hahahakeebs/Willihs/pcb/willihs.kicad_pcb

## KiCad design pcb/willihs.kicad_pcb (2025-08-03)

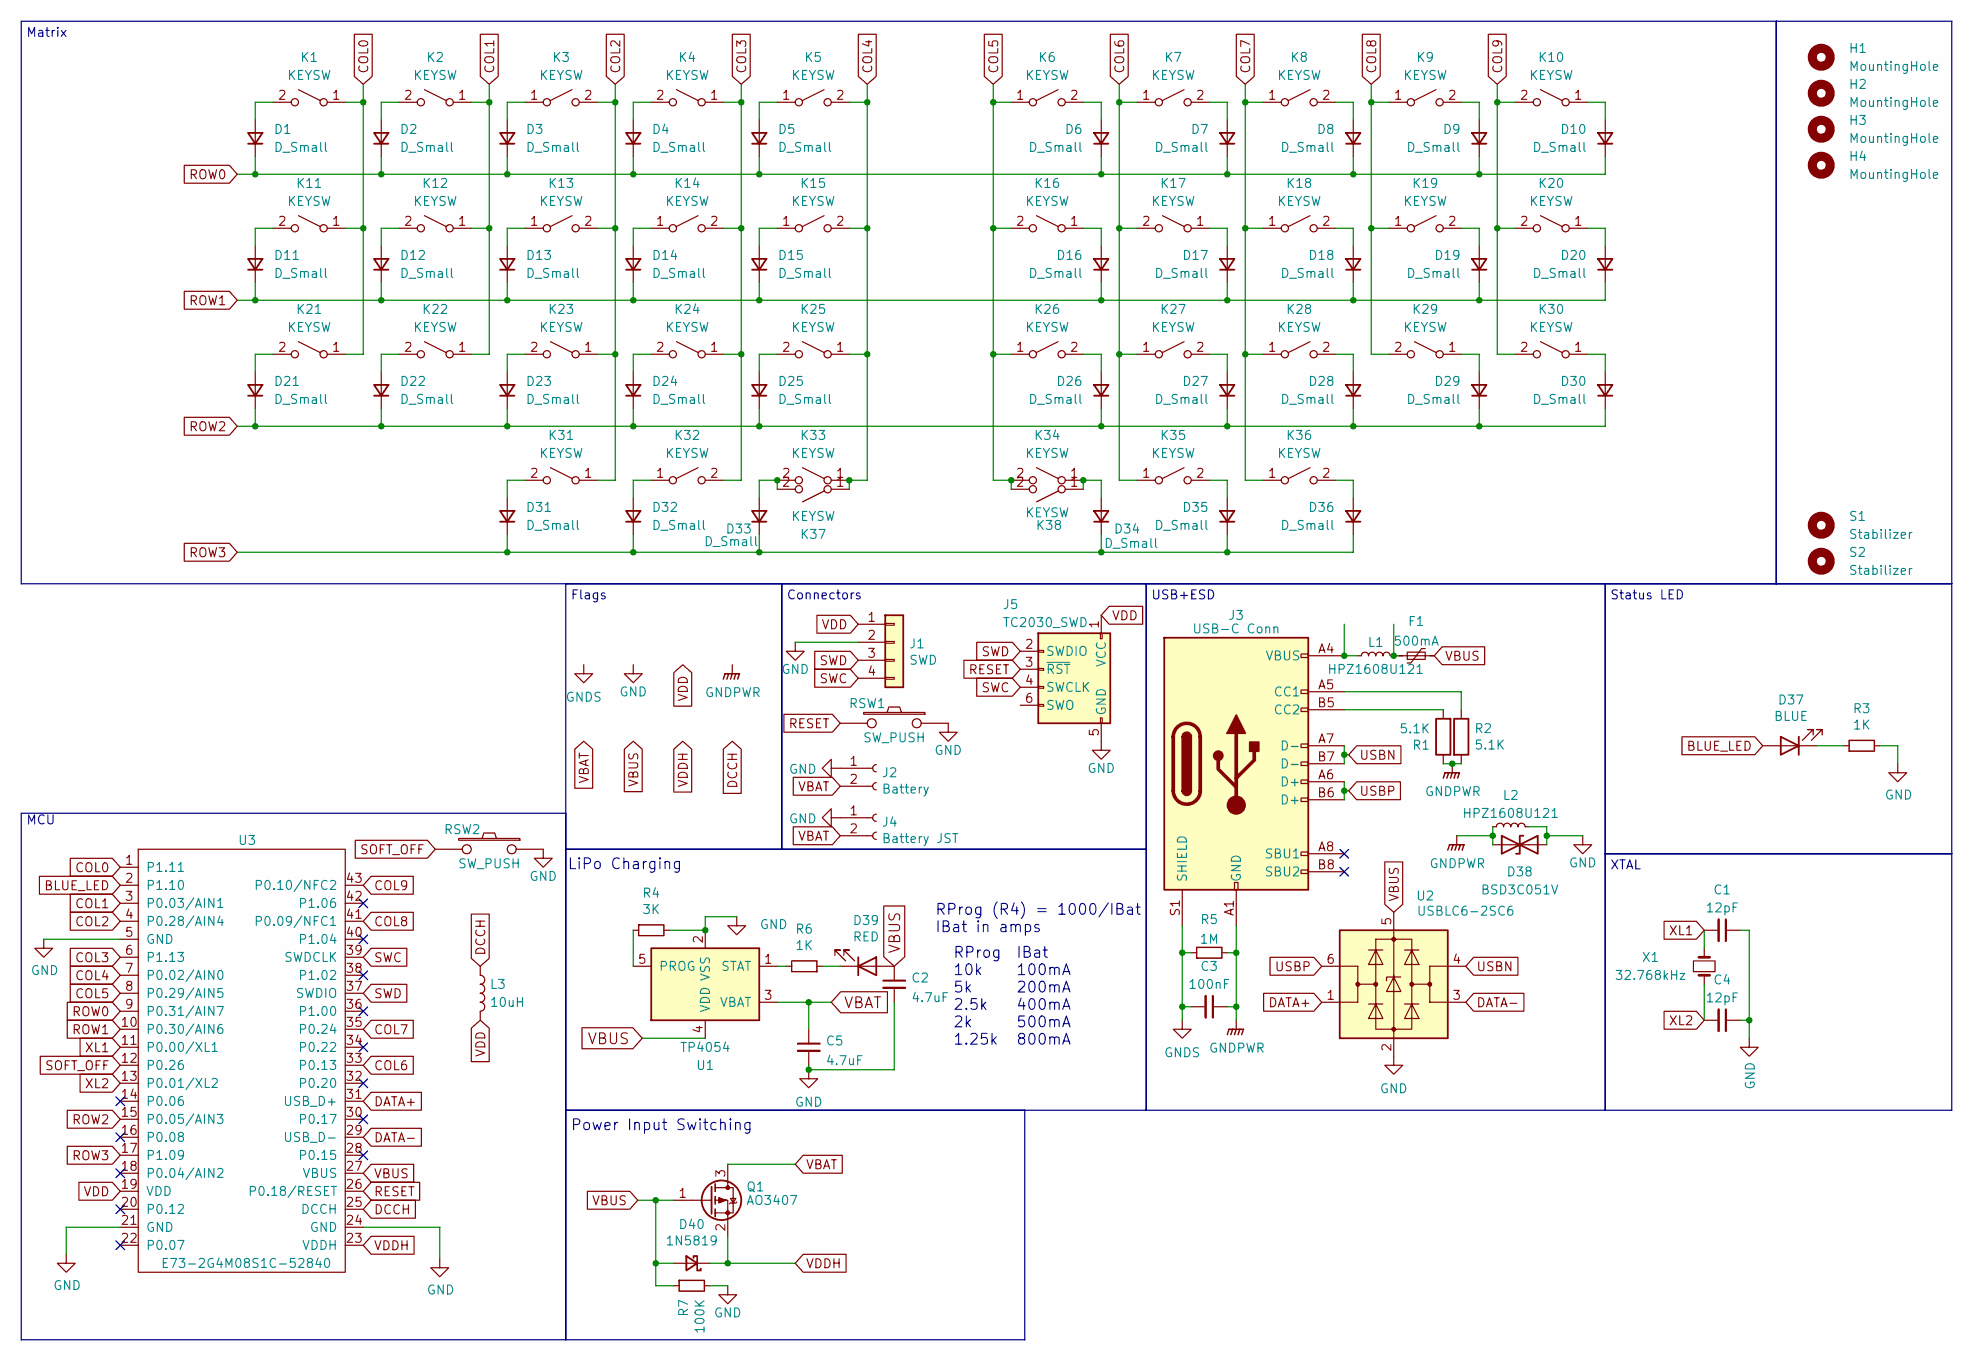
[picture p1: schematic willihs.kicad_sch, Willis]

Parts:
C1, C4: 12pF; C_0603_1608Metric_Pad1.08x0.95mm_HandSolder; LCSC C1642
C2, C5: 4.7uF; C_0603_1608Metric_Pad1.08x0.95mm_HandSolder; LCSC C19666
C3: 100nF; C_0603_1608Metric_Pad1.08x0.95mm_HandSolder; LCSC C1588
D1, D2, D3, D4, D5, D6, D7, D8, D9, D10, D11, D12, D13, D14, D15, D16, D17, D18, D19, D20, D21, D22, D23, D24, D25, D26, D27, D28, D29, D30, D31, D32, D33, D34, D35, D36: D_Small; D_SOD-323_HandSoldering; LCSC C2128
D37: BLUE; LED_1206_3216Metric_ReverseMount_Hole1.8x2.4mm; LCSC C375563
D38: BSD3C051V; D_SOD-323_HandSoldering; LCSC C151996
D39: RED; LED_1206_3216Metric_ReverseMount_Hole1.8x2.4mm; LCSC C375561
D40: 1N5819; D_SOD-323_HandSoldering; LCSC C21714236
F1: 500mA; Fuse_1206_3216Metric_Pad1.42x1.75mm_HandSolder; LCSC C883122
H1, H2, H3, H4: MountingHole; M2_Hole_TH_mod
J1: SWD; connector_swd_REV
J2: Battery; Battery_TH
J3: USB-C Conn; USB_C_Receptacle_HRO_TYPE-C-31-M-12; LCSC C165948
J4: Battery JST; JST_SH_SM02B-SRSS-TB_1x02-1MP_P1.00mm_Horizontal; LCSC C160402
J5: TC2030_SWD; CON_TC2030_outlined
K1, K2, K3, K4, K5, K6, K7, K8, K9, K10, K11, K12, K13, K14, K15, K16, K17, K18, K19, K20, K21, K22, K23, K24, K25, K26, K27, K28, K29, K30, K31, K32, K33, K34, K35, K36, K37, K38: KEYSW; SW_MX_1u
L1, L2: HPZ1608U121; L_0603_1608Metric_Pad1.05x0.95mm_HandSolder; LCSC C919153
L3: 10uH; L_0603_1608Metric_Pad1.05x0.95mm_HandSolder; LCSC C275361
Q1: AO3407; SOT-23_Handsoldering; LCSC C5148473
R1, R2: 5.1K; R_0603_1608Metric_Pad0.98x0.95mm_HandSolder; LCSC C105580
R3, R6: 1K; R_0603_1608Metric_Pad0.98x0.95mm_HandSolder; LCSC C22548
R4: 3K; R_0603_1608Metric_Pad0.98x0.95mm_HandSolder; LCSC C4211
R5: 1M; R_0603_1608Metric_Pad0.98x0.95mm_HandSolder; LCSC C22935
R7: 100K; R_0603_1608Metric_Pad0.98x0.95mm_HandSolder; LCSC C14675
RSW1, RSW2: SW_PUSH; SW_SPST_EVQP7C; LCSC C388883
S1, S2: Stabilizer; STAB_MX_P_2u
U1: TP4054; SOT-23-5_HandSoldering; LCSC C424093
U2: USBLC6-2SC6; TSOT-23-6_HandSoldering; LCSC C558442
U3: E73-2G4M08S1C-52840; LCSC C356849
X1: 32.768kHz; Crystal_SMD_MicroCrystal_CM9V-T1A-2Pin_1.6x1.0mm_HandSolder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; LCSC C383846

Connections:
BLUE_LED: D37.2 (A), U3.2 (P1.10)
COL0: K1.1 (A), K11.1 (A), K21.1 (A), U3.1 (P1.11)
COL1: K2.1 (A), K12.1 (A), K22.1 (A), U3.3 (P0.03/AIN1)
COL2: K3.2 (B), K13.2 (B), K23.1 (A), K31.1 (A), U3.4 (P0.28/AIN4)
COL3: K4.1 (A), K14.2 (B), K24.1 (A), K32.2 (B), U3.6 (P1.13)
COL4: K5.2 (B), K15.2 (B), K25.1 (A), K33.1 (A), K37.1 (A), U3.7 (P0.02/AIN0)
COL5: K6.1 (A), K16.2 (B), K26.1 (A), K34.2 (B), K38.2 (B), U3.8 (P0.29/AIN5)
COL6: K7.1 (A), K17.2 (B), K27.1 (A), K35.1 (A), U3.33 (P0.13)
COL7: K8.1 (A), K18.1 (A), K28.1 (A), K36.1 (A), U3.35 (P0.24)
COL8: K9.1 (A), K19.1 (A), K29.2 (B), U3.41 (P0.09/NFC1)
COL9: K10.2 (B), K20.2 (B), K30.2 (B), U3.43 (P0.10/NFC2)
DATA+: U2.1 (I/O1), U3.31 (USB_D+)
DATA-: U2.3 (I/O2), U3.29 (USB_D-)
DCCH: L3.1, U3.25 (DCCH)
GND: C1.1, C2.2, C4.1, C5.2, D38.2 (A2), J1.2, J2.1, J4.1, J5.5 (GND), L2.2, R3.2, R4.2, R7.2, RSW1.1, RSW2.1, U1.2 (VSS), U2.2 (GND), U3.5 (GND), U3.21 (GND), U3.24 (GND)
GNDPWR: C3.1, D38.1 (A1), J3.A1 (GND), J3.A12 (GND), J3.B1 (GND), J3.B12 (GND), L2.1, R1.1, R2.2, R5.2
GNDS: C3.2, J3.S1 (SHIELD), R5.1
unnamed: D1.2 (A), K1.2 (B)
unnamed: D2.2 (A), K2.2 (B)
unnamed: D3.2 (A), K3.1 (A)
unnamed: D4.2 (A), K4.2 (B)
unnamed: D5.2 (A), K5.1 (A)
unnamed: D6.2 (A), K6.2 (B)
unnamed: D7.2 (A), K7.2 (B)
unnamed: D8.2 (A), K8.2 (B)
unnamed: D9.2 (A), K9.2 (B)
unnamed: D10.2 (A), K10.1 (A)
unnamed: D11.2 (A), K11.2 (B)
unnamed: D12.2 (A), K12.2 (B)
unnamed: D13.2 (A), K13.1 (A)
unnamed: D14.2 (A), K14.1 (A)
unnamed: D15.2 (A), K15.1 (A)
unnamed: D16.2 (A), K16.1 (A)
unnamed: D17.2 (A), K17.1 (A)
unnamed: D18.2 (A), K18.2 (B)
unnamed: D19.2 (A), K19.2 (B)
unnamed: D20.2 (A), K20.1 (A)
unnamed: D21.2 (A), K21.2 (B)
unnamed: D22.2 (A), K22.2 (B)
unnamed: D23.2 (A), K23.2 (B)
unnamed: D24.2 (A), K24.2 (B)
unnamed: D25.2 (A), K25.2 (B)
unnamed: D26.2 (A), K26.2 (B)
unnamed: D27.2 (A), K27.2 (B)
unnamed: D28.2 (A), K28.2 (B)
unnamed: D29.2 (A), K29.1 (A)
unnamed: D30.2 (A), K30.1 (A)
unnamed: D31.2 (A), K31.2 (B)
unnamed: D32.2 (A), K32.1 (A)
unnamed: D33.2 (A), K33.2 (B), K37.2 (B)
unnamed: D34.2 (A), K34.1 (A), K38.1 (A)
unnamed: D35.2 (A), K35.2 (B)
unnamed: D36.2 (A), K36.2 (B)
unnamed: D37.1 (K), R3.1
unnamed: D39.1 (K), R6.1
unnamed: F1.1, L1.2
unnamed: J3.A5 (CC1), R2.1
unnamed: J3.B5 (CC2), R1.2
unnamed: J3.A4 (VBUS), J3.A9 (VBUS), J3.B4 (VBUS), J3.B9 (VBUS), L1.1
unnamed: R4.1, U1.5 (PROG)
unnamed: R6.2, U1.1 (STAT)
RESET: J5.3 (~RST), RSW1.2, U3.26 (P0.18/RESET)
ROW0: D1.1 (K), D2.1 (K), D3.1 (K), D4.1 (K), D5.1 (K), D6.1 (K), D7.1 (K), D8.1 (K), D9.1 (K), D10.1 (K), U3.9 (P0.31/AIN7)
ROW1: D11.1 (K), D12.1 (K), D13.1 (K), D14.1 (K), D15.1 (K), D16.1 (K), D17.1 (K), D18.1 (K), D19.1 (K), D20.1 (K), U3.10 (P0.30/AIN6)
ROW2: D21.1 (K), D22.1 (K), D23.1 (K), D24.1 (K), D25.1 (K), D26.1 (K), D27.1 (K), D28.1 (K), D29.1 (K), D30.1 (K), U3.15 (P0.05/AIN3)
ROW3: D31.1 (K), D32.1 (K), D33.1 (K), D34.1 (K), D35.1 (K), D36.1 (K), U3.17 (P1.09)
SOFT_OFF: RSW2.2, U3.12 (P0.26)
SWC: J1.4, J5.4 (SWCLK), U3.39 (SWDCLK)
SWD: J1.3, J5.2 (SWDIO), U3.37 (SWDIO)
USBN: J3.A7 (D-), J3.B7 (D-), U2.4 (I/O2)
USBP: J3.A6 (D+), J3.B6 (D+), U2.6 (I/O1)
VBAT: C5.1, J2.2, J4.2, Q1.3 (D), U1.3 (VBAT)
VBUS: C2.1, D39.2 (A), D40.2 (A), F1.2, Q1.1 (G), R7.1, U1.4 (VDD), U2.5 (VBUS), U3.27 (VBUS)
VDD: J1.1, J5.1 (VCC), L3.2, U3.19 (VDD)
VDDH: D40.1 (K), Q1.2 (S), U3.23 (VDDH)
XL1: C1.2, U3.11 (P0.00/XL1), X1.2
XL2: C4.2, U3.13 (P0.01/XL2), X1.1

Notes on the sheet:
Power Input Switching
Status LED
Connectors
XTAL
USB+ESD
RProg (R4) = 1000/IBat IBat in amps
MCU
RProg 10k 5k 2.5k 2k 1.25k
Flags
LiPo Charging
Matrix
IBat 100mA 200mA 400mA 500mA 800mA

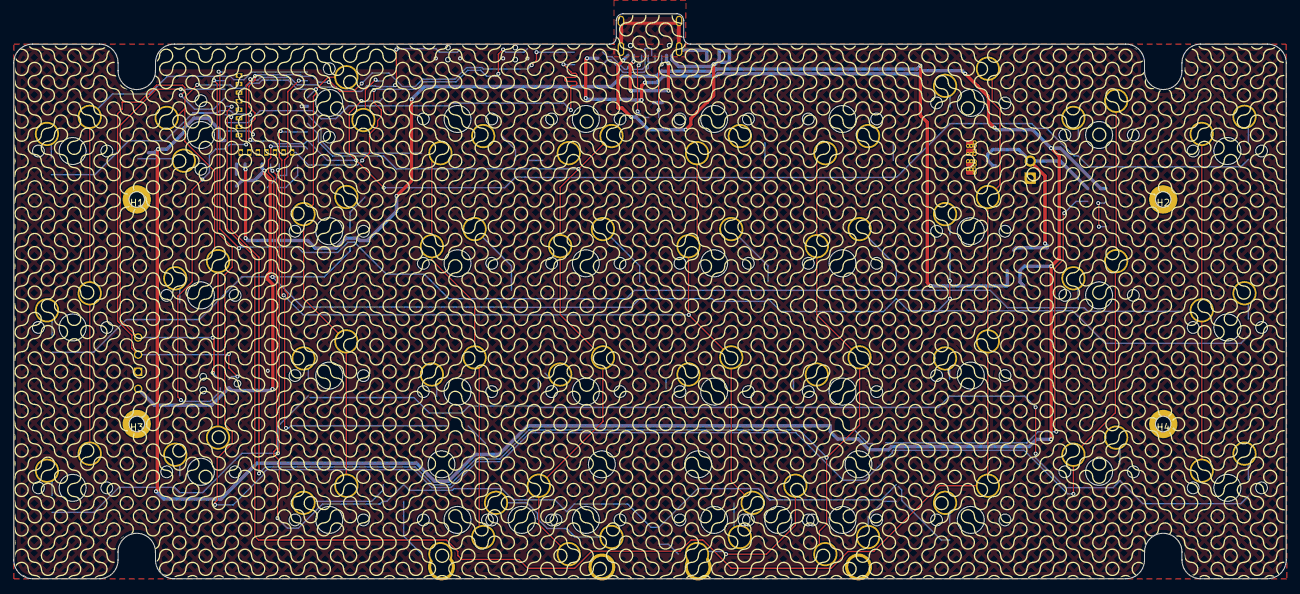
[picture p2: board willihs.kicad_pcb from above]

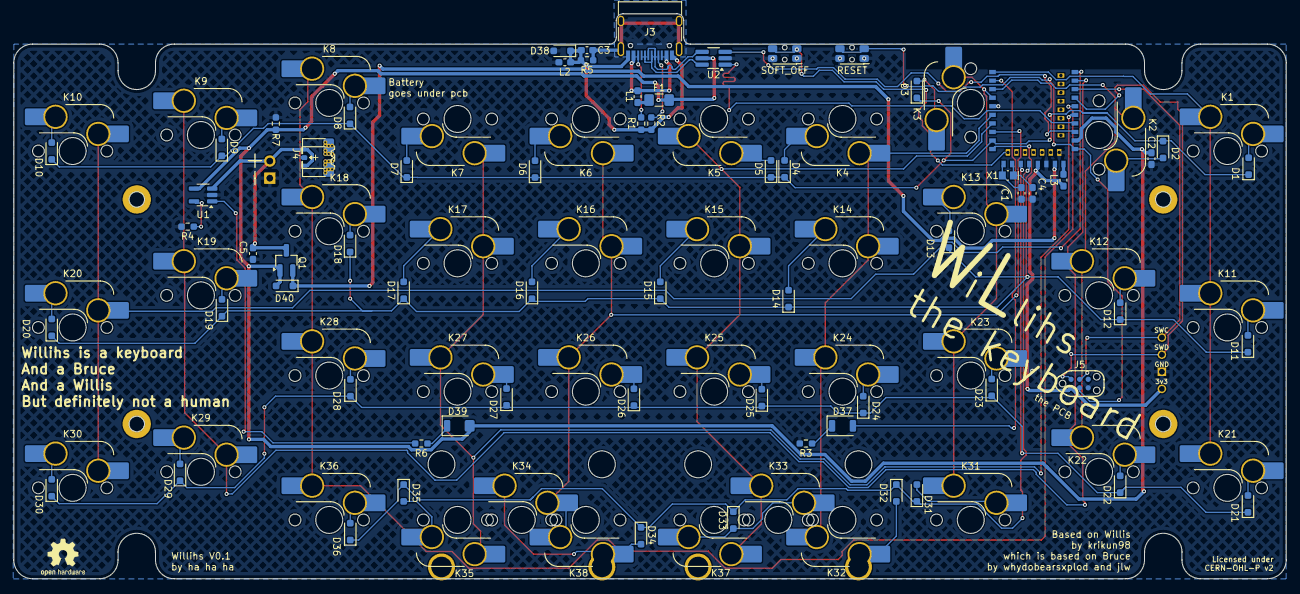
[picture p3: board willihs.kicad_pcb from below]

Board: 2 copper layers, 188.9 x 83.9 mm, 112 parts (67 on the bottom side), 77 nets.
