hahahakeebs/Willihs/(commit log)

2025-06-16 first draft of new pcb
    [bom.csv, designators.csv, positions.csv, willihs.kicad_sch]
2025-06-25 updated pcb and gerbs
    [bom.csv, positions.csv]
